serhuis/StopWater/assembly.FCStd

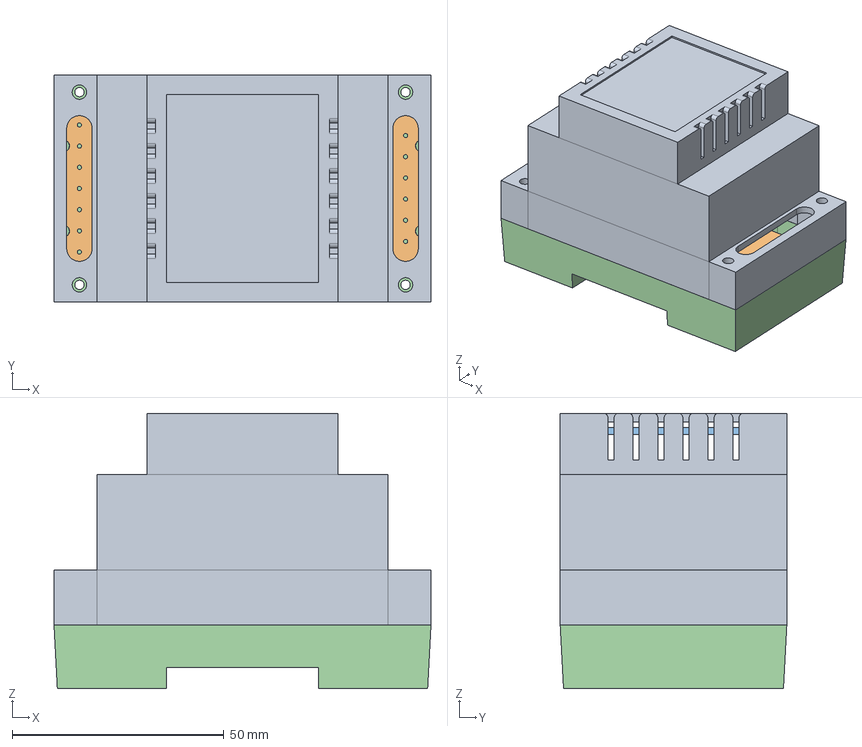
[picture p1: CAD file, 2023-11-07]
assembly.FCStd
89.0 x 53.5 x 65.0 mm
Kradex_z102_top_001
pcb1_001
pcb2_001
Kradex_z102_bottom_001
