serhuis/StopWater/Kradex_z102_top.FCStd

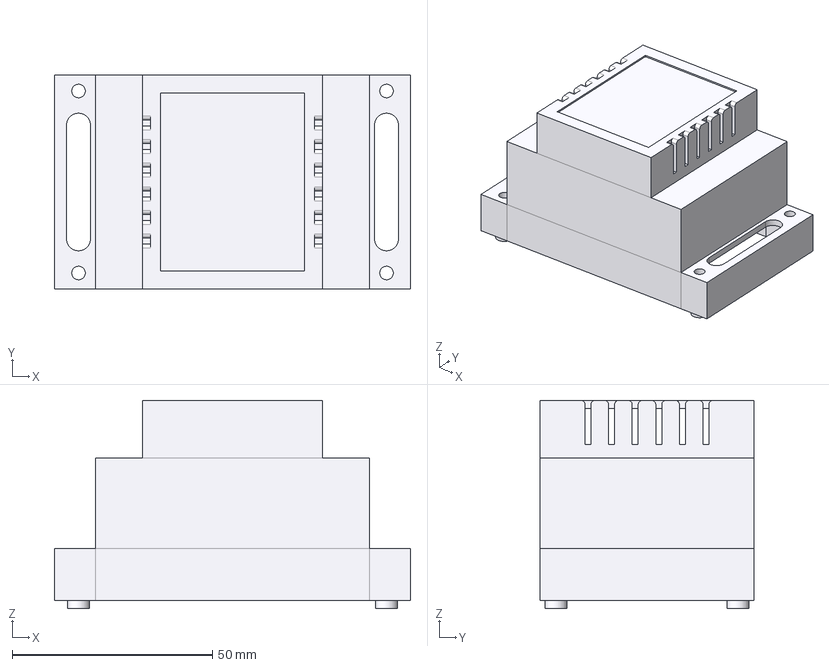
[picture p2: CAD file, 2023-11-07]
Kradex_z102_top.FCStd
89.0 x 53.5 x 52.0 mm
