serhuis/StopWater/Kradex_z102_bottom.FCStd

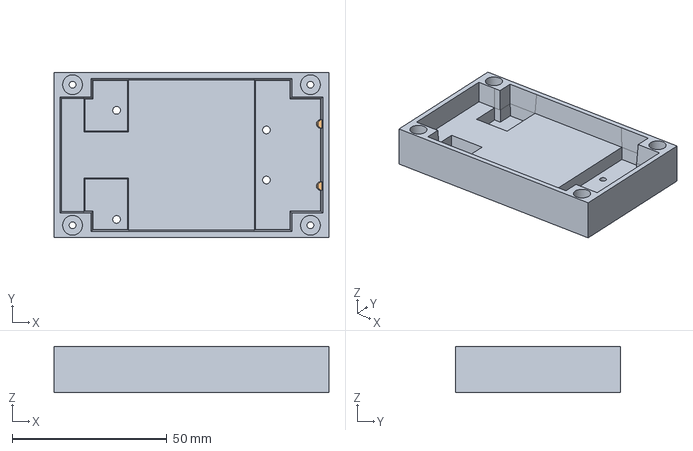
[picture p3: CAD file, 2023-11-07]
Kradex_z102_bottom.FCStd
89.0 x 53.5 x 15.0 mm
