serhuis/StopWater/DG301-5.0.FCStd

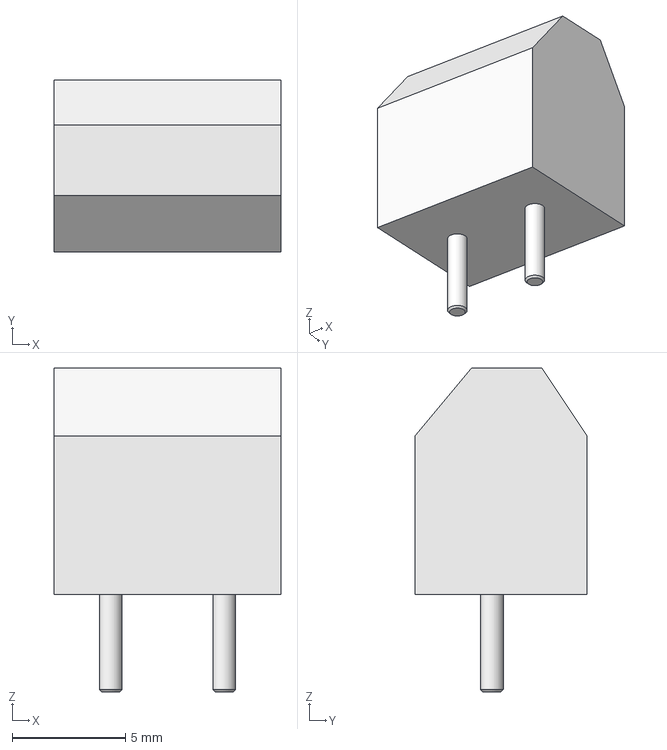
[picture p4: CAD file, 2023-11-07]
DG301-5.0.FCStd
10.0 x 7.60 x 14.3 mm
