serhuis/StopWater/pcb2.FCStd

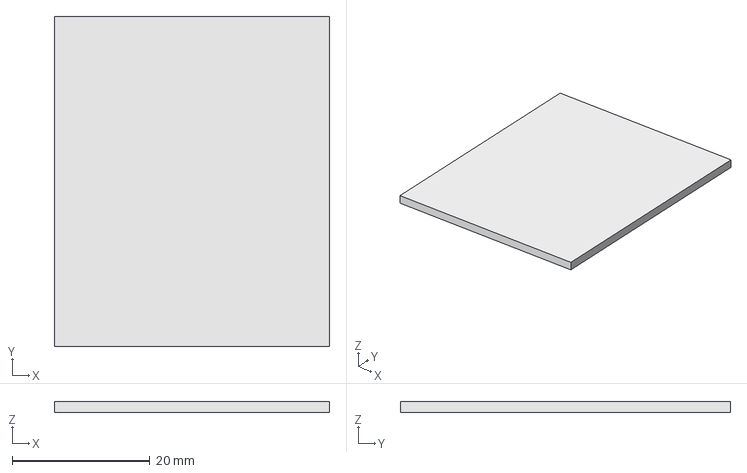
[picture p5: CAD file, 2023-11-07]
pcb2.FCStd
40.0 x 48.0 x 1.60 mm
