serhuis/StopWater/pcb2-BodyPad.dxf

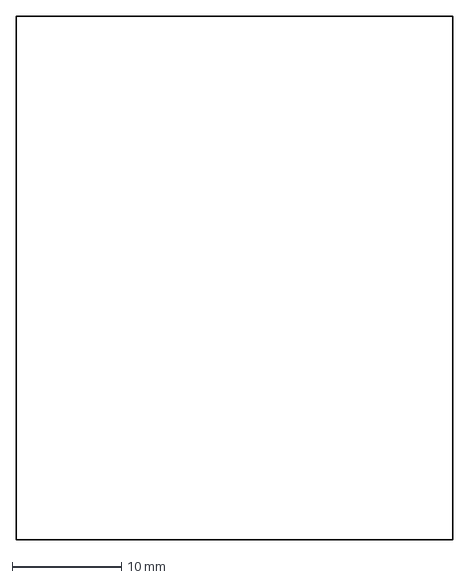
[picture p6: CAD file, 2023-11-07]
pcb2-BodyPad.dxf
40.0 x 48.0 mm
