serhuis/StopWater/pcb1.FCStd

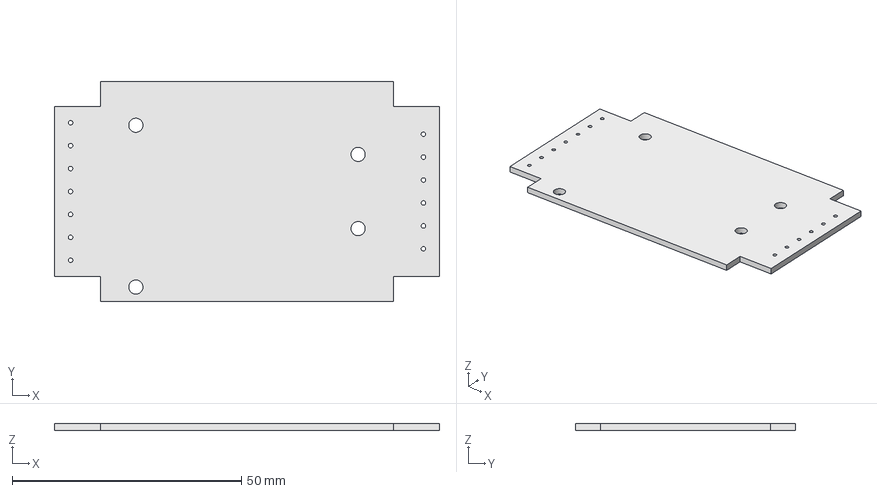
[picture p7: CAD file, 2023-11-07]
pcb1.FCStd
84.0 x 48.0 x 1.60 mm
