serhuis/StopWater/pcb1,1-Extrude.dxf

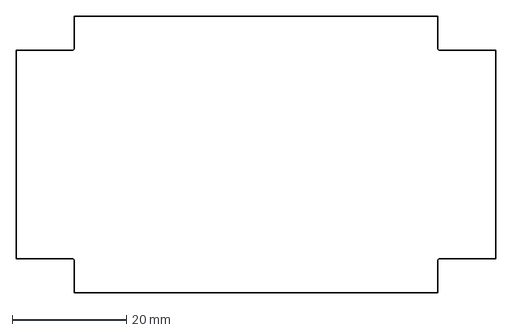
[picture p8: CAD file, 2023-06-02]
pcb1,1-Extrude.dxf
83.9 x 48.4 mm
