serhuis/StopWater/ex1-BodyPad001.stl

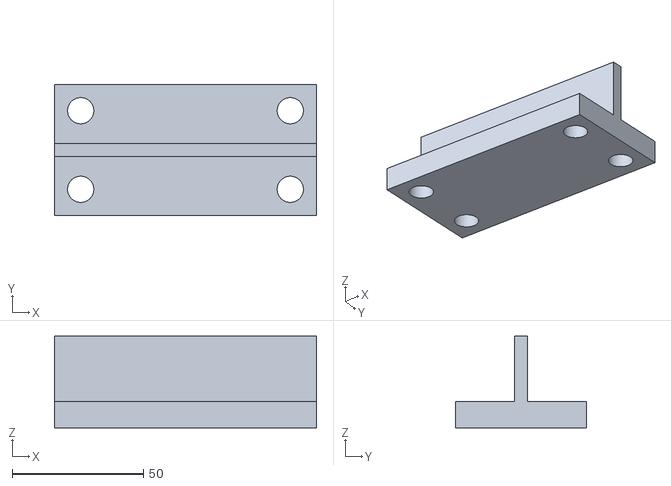
[picture p9: CAD file, 2023-06-02]
ex1-BodyPad001.stl
100.0 x 50.0 x 35.0
