serhuis/StopWater/ex1.FCStd

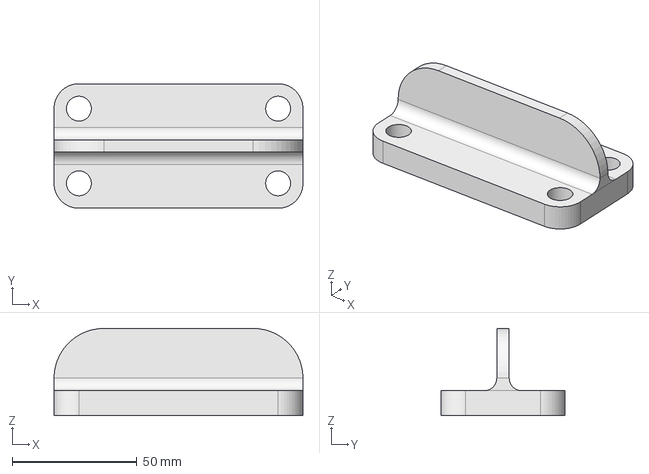
[picture p10: CAD file, 2023-06-02]
ex1.FCStd
100.0 x 50.0 x 35.0 mm
