serhuis/StopWater/pcb1-Extrude.dxf

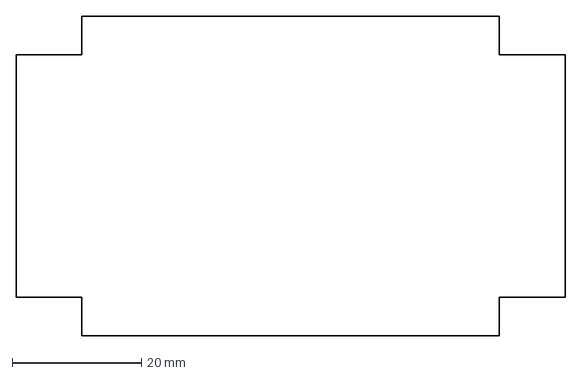
[picture p11: CAD file, 2023-06-02]
pcb1-Extrude.dxf
85.0 x 49.5 mm
