serhuis/StopWater/Gainta_d4mg.FCStd

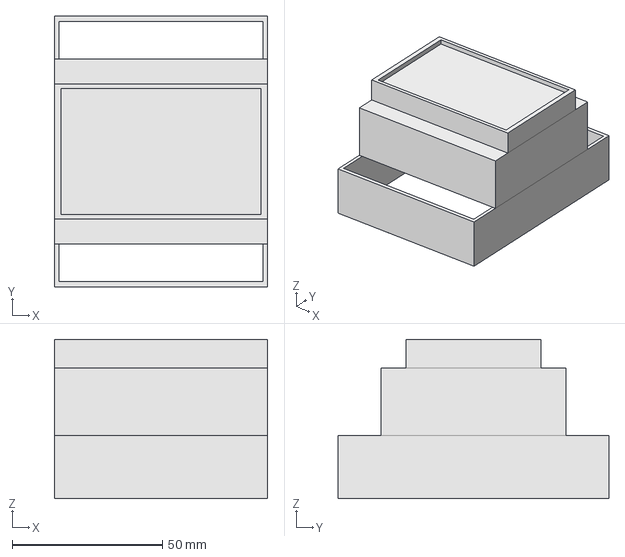
[picture p12: CAD file, 2023-06-02]
Gainta_d4mg.FCStd
71.0 x 90.2 x 53.0 mm
