serhuis/StopWater/(list of files, cad)

Other CAD files:
ex1-BodyFillet002.stl
