serhuis/StopWater/stopwater/stopwater.kicad_pcb

## KiCad design stopwater/stopwater.kicad_pcb (2023-11-07)

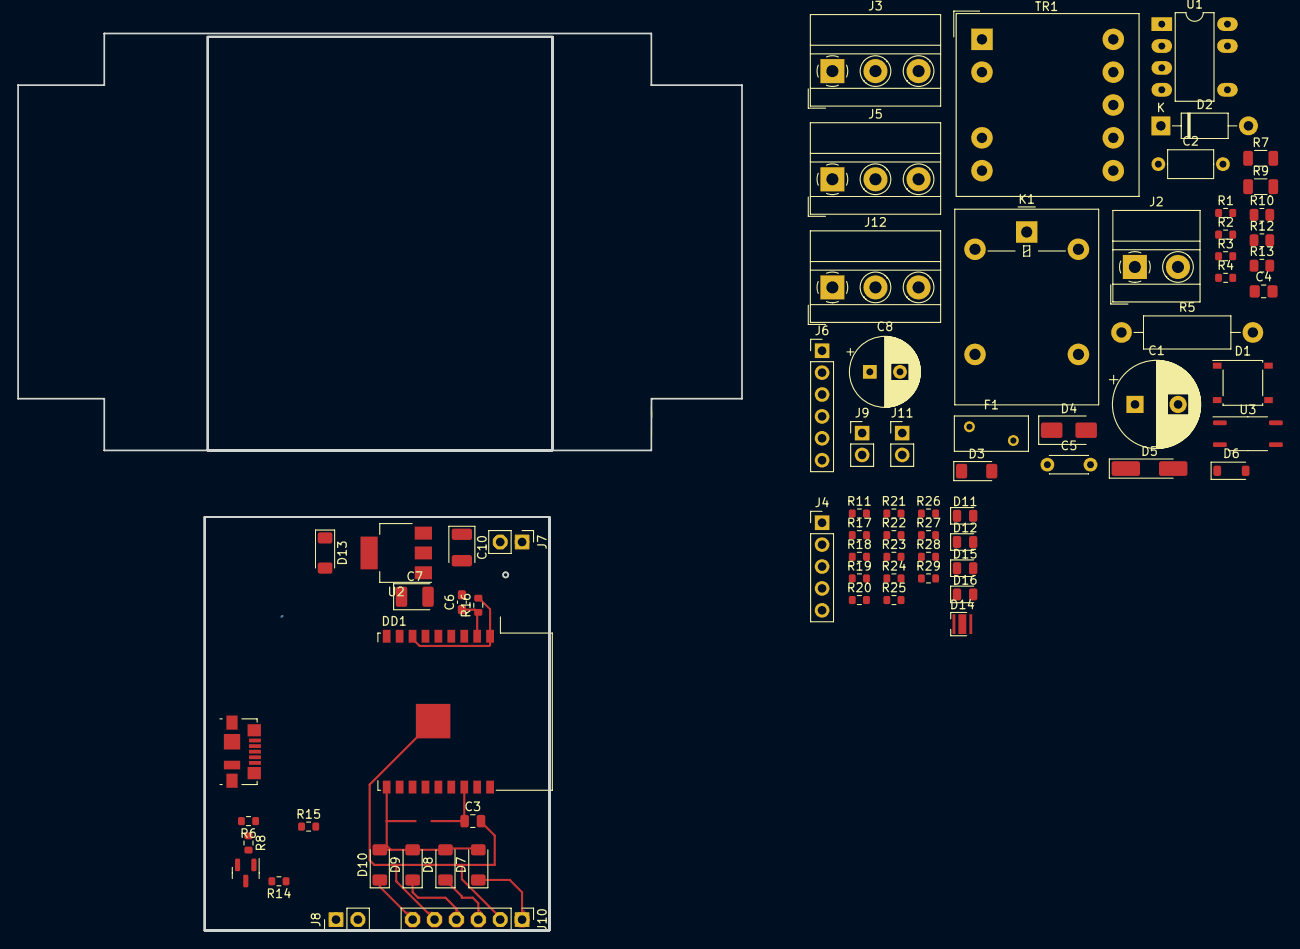
[picture p13: board stopwater.kicad_pcb from above]

Board: 2 copper layers, 84.0 x 104.1 mm, 74 parts (0 on the bottom side), 57 nets.

Parts:
C1: 10u 400v; CP_Radial_D10.0mm_P5.00mm
C2: 2.2n; C_Axial_L5.1mm_D3.1mm_P7.50mm_Horizontal
C3: 1u; C_0805_2012Metric
C4: C_Polarized_Small; C_0805_2012Metric_Pad1.18x1.45mm_HandSolder
C5: C_Polarized_Small; C_Disc_D4.3mm_W1.9mm_P5.00mm
C6: 0.1u; C_0603_1608Metric_Pad1.08x0.95mm_HandSolder
C7, C10: 10u; CP_EIA-3528-15_AVX-H
C8: 200u 16v; CP_Radial_D8.0mm_P3.50mm
D1: ABS10; Diode_Bridge_Diotec_ABS
D2: 1N4937; D_DO-41_SOD81_P10.16mm_Horizontal
D3, D7, D8, D9, D10, D13: LL4148; D_MiniMELF
D4: SS14; D_SMA
D5: 8v2; D_MiniMELF_Handsoldering
D6: MMSD4148; D_SOD-123
D11, D12: "SENS_1"; LED_0805_2012Metric
D14: LED_Dual_AAK; LED_Cree-XB
D15: "SENS_3"; LED_0805_2012Metric
D16: "SENS_4"; LED_0805_2012Metric
DD1: ESP32c3-WROOM-02; ESP-WROOM-02
F1: 8.2R; Fuse_BelFuse_0ZRE0005FF_L8.3mm_W3.8mm
J1: USB_B_Micro; USB_Micro-B_Molex_47346-0001
J2: ~220; TerminalBlock_MetzConnect_Type011_RT05502HBWC_1x02_P5.00mm_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
J3, J5, J12: Out; TerminalBlock_MetzConnect_Type011_RT05503HBWC_1x03_P5.00mm_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
J4: Conn_01x05; PinHeader_1x05_P2.54mm_Vertical
J6: Conn_01x06_Pin; PinHeader_1x06_P2.54mm_Vertical
J7, J9: Conn_01x02_Pin; PinHeader_1x02_P2.54mm_Vertical
J8, J11: Conn_01x02_Socket; PinHeader_1x02_P2.54mm_Vertical
J10: Conn_01x06_Socket; PinHeader_1x06_P2.54mm_Vertical
K1: G5LE-1; Relay_SPDT_Omron-G5LE-1
Q1: BC847; SOT-23
R1, R2, R3, R4, R14: 3.3k; R_0603_1608Metric
R5: 200k; R_Axial_DIN0411_L9.9mm_D3.6mm_P15.24mm_Horizontal
R6: 330; R_0603_1608Metric
R7, R9: 1M; R_1206_3216Metric
R8, R11, R16, R17, R18, R19, R20, R21, R22, R23, R24, R25, R26, R27, R28, R29: 10k; R_0603_1608Metric
R10: 10k; R_0805_2012Metric
R12: 330; R_0805_2012Metric
R13: 680; R_0805_2012Metric
R15: 1k; R_0603_1608Metric
TR1: FAT_74082
U1: TNY268P; PowerIntegrations_PDIP-8B
U2: LD1117S33TR_SOT223; SOT-223-3_TabPin2
U3: TLP181; SOIC-4_4.55x3.7mm_P2.54mm

Connections:
+3.3V: C3.1, C7.1, DD1.1 (3V3), R11.1, R16.2, R17.1, R18.1, R19.1, R20.1, R21.1, R22.1, R23.1, R24.1, R25.1, R26.1, R27.1, R28.1, R29.1, U2.2 (VO)
+12V: C8.1 (plus), D4.1 (K), D5.1 (K), D6.1 (K), D6.2 (A), J8.1, J9.1, J9.2, J11.1, K1.2, K1.5, R1.1, R2.1, R3.1, R4.1
/+12: C10.1, D13.1 (K), J7.1, U2.3 (VI)
/IO_0: D7.2 (A), DD1.18 (IO0), R17.2
/IO_1: D8.2 (A), DD1.17 (IO1), R18.2
/IO_2: DD1.16 (IO2), R19.2
/IO_3: D9.2 (A), DD1.15 (IO3), R20.2
/IO_4: DD1.3 (IO4), R6.2, R15.2, R21.2
/IO_5: D11.1 (K), DD1.4 (IO5), R22.2
/IO_6: D12.1 (K), DD1.5 (IO6), R23.2
/IO_7: D15.1 (K), DD1.6 (IO7), R24.2
/IO_8: D16.1 (K), DD1.7 (IO8), R25.2
/IO_9: DD1.8 (IO9), J4.2, R26.2
/IO_10: D10.2 (A), DD1.10 (IO10)
/SENSOR_1: D7.1 (K), J10.1
/SENSOR_2: D8.1 (K), J10.3
/SENSOR_3: D9.1 (K), J10.4
/SENSOR_4: D10.1 (K), J10.6
/USB_DN: DD1.13 (IO18), J1.2 (D-)
/USB_DP: DD1.14 (IO19), J1.3 (D+)
/power/SENSOR_1: J3.1, J6.1, R1.2
/power/SENSOR_2: J3.3, J6.3, R2.2, R3.2
/power/SENSOR_3: J5.1, J6.4
/power/SENSOR_4: J5.3, J6.6, R4.2
GND: C3.2, C6.2, C7.2, C10.2, D14.3 (K), DD1.9 (GND), DD1.19 (GND), J1.5 (GND), J1.6 (Shield), J3.2, J4.3, J5.2, J6.2, J6.5, J7.2, J10.2, J10.5, J11.2, Q1.2 (E), R8.1, R13.2, U2.1 (GND), U3.3
unnamed: C1.2 (minus), C4.2 (minus), D1.2 (-), TR1.1, U1.2 (S), U1.3 (S), U1.7 (S), U1.8 (S), U3.4
unnamed: C1.1 (plus), C2.2, C5.2 (minus), D1.1 (+), R5.2, R7.2, TR1.5
unnamed: C4.1 (plus), R10.2, U1.1 (BP)
unnamed: C5.1 (plus), C8.2 (minus), TR1.10
unnamed: D1.3, F1.2
unnamed: D2.2 (A), TR1.4, U1.5 (D)
unnamed: C2.1, D2.1 (K), R5.1
unnamed: D3.2 (A), TR1.2
unnamed: D3.1 (K), R10.1
unnamed: D4.2 (A), TR1.6
unnamed: D5.2 (A), R12.2
unnamed: D11.2 (A), R11.2
unnamed: D12.2 (A), R27.2
unnamed: D13.2 (A), J1.1 (VBUS)
unnamed: D14.1 (A1), R15.1
unnamed: D14.2 (A2), R14.1
unnamed: D15.2 (A), R28.2
unnamed: D16.2 (A), R29.2
unnamed: C6.1, DD1.2 (EN), J4.1, R16.1
unnamed: DD1.11 (RXD), J4.4
unnamed: DD1.12 (TXD), J4.5
unnamed: F1.1, J2.1
unnamed: D1.4, J2.2
unnamed: J8.2, Q1.3 (C), R14.2
unnamed: J12.1, K1.4
unnamed: J12.2, K1.1
unnamed: J12.3, K1.3
unnamed: Q1.1 (B), R6.1, R8.2
unnamed: R7.1, R9.2
unnamed: R12.1, R13.1, U3.1
unnamed: TR1.7, TR1.9
unnamed: R9.1, U1.4 (EN/UV), U3.6
