serhuis/StopWater/stopwater/PCB_zhaga_ready.kicad_pcb

## KiCad design stopwater/PCB_zhaga_ready.kicad_pcb (2023-11-07)

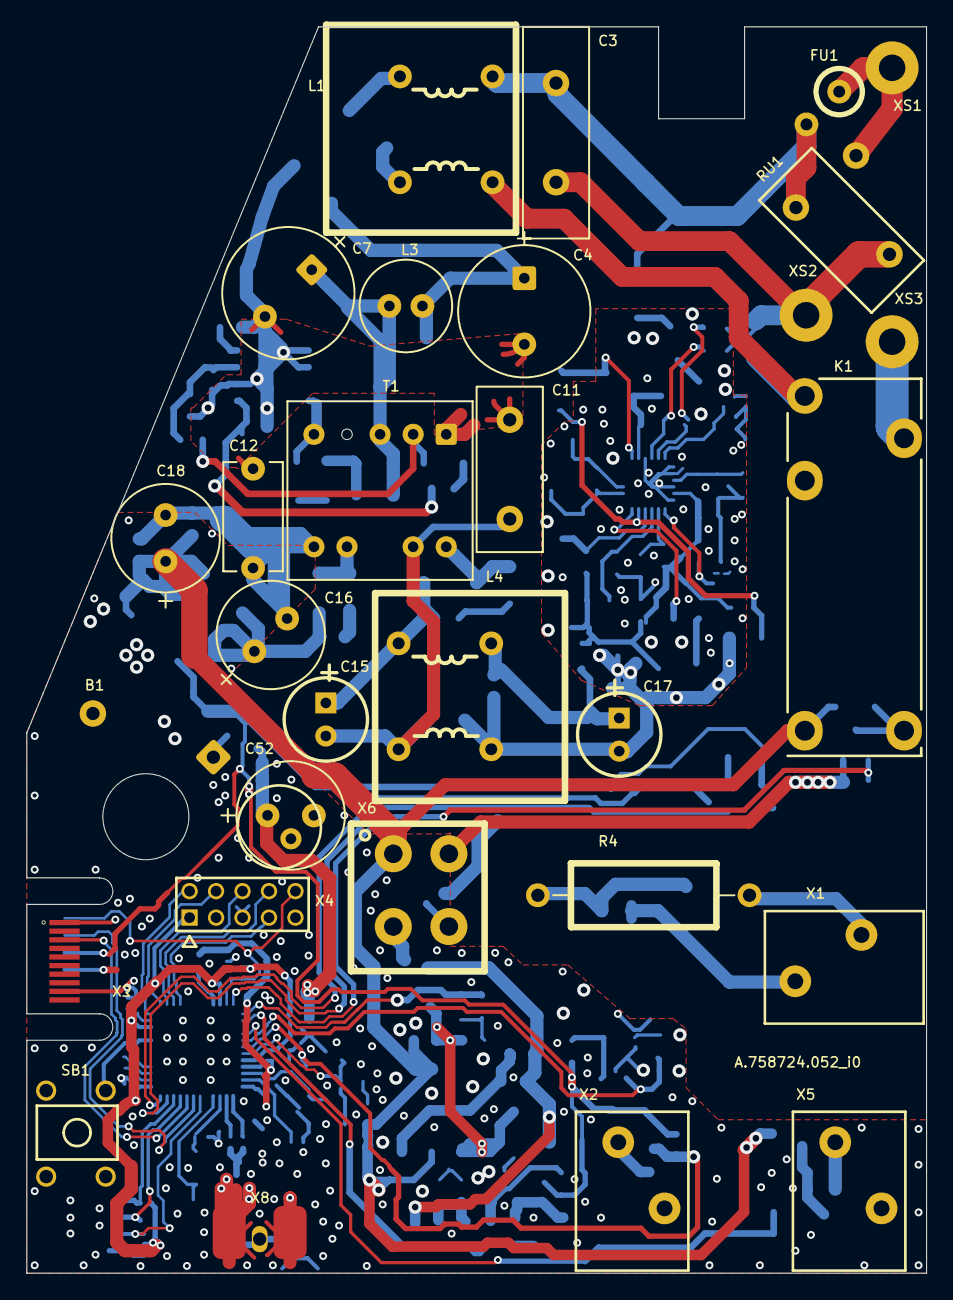
[picture p14: board PCB_zhaga_ready.kicad_pcb from above]

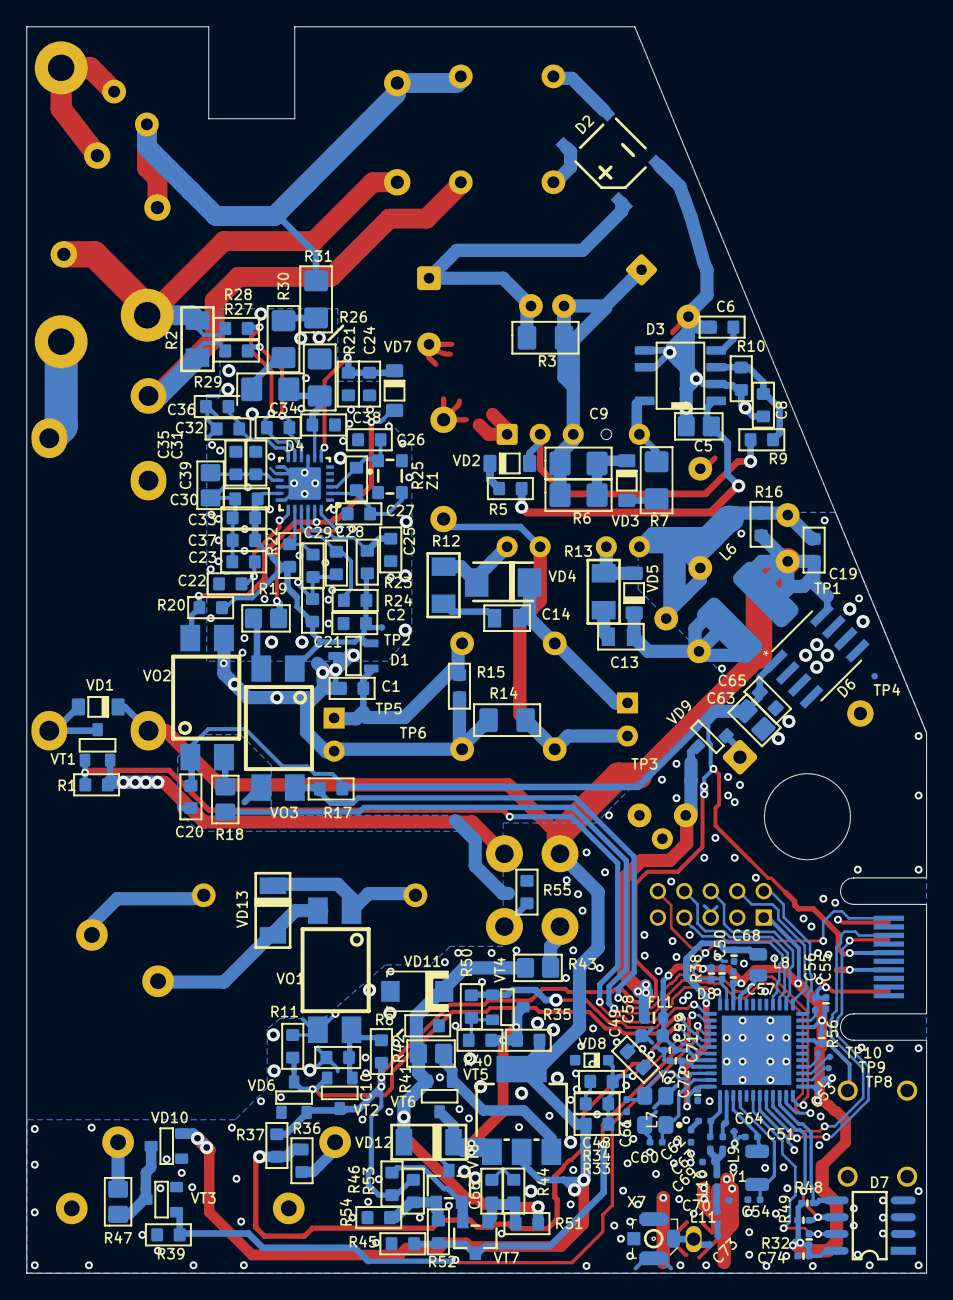
[picture p15: board PCB_zhaga_ready.kicad_pcb from below]

Board: 2 copper layers, 68.0 x 94.2 mm, 192 parts (162 on the bottom side), 105 nets.

Parts:
B1: BR-1225/VCN
C1, C6, C8, C34, C38, C49: 10nF 0603; 0603
C2: 22u 0603; 0603
C3: 1000pF 300VAC; L16W5 V
C4, C7: 4.7uF 400V; D10P5L12
C5: 10uF 35V; 0805
C9: 1000pF 300VAC; 1206
C10: 470nF 0603; 0603
C11: 1000pF 300VAC; L12.5W5
C12: 1000pF 300VAC; L7.5W5H6P7.5
C13, C14: SMD 0805-1000пФ±5% 50В X7R; __Altium_Library_Footprints_Passive.PcbLib_0805
C15, C17: 100uF 10V; D6.3P2.5L11.5
C16, C18: 470uF 10V; D8P3.5L12
C19, C20, C21, C23, C24, C25, C28, C29, C33, C35, C36, C48, C65, C66: SMD 0603-0.1мкФ±10% 25В X7R; 0603
C22, C37: SMD 0603-0,022мкФ±10% 25В X7R; 0603
C26, C27: SMD 0603 18pF±5% 50В; 0603
C30, C31, C32: 150pF 0603; 0603
C39: 2.2u 0805; 0805
C50, C53, C55, C57, C59, C68, C71, C72, C74: Cap; rlc_402_smd
C51, C54, C60, C61, C73: 12pF; CAPC1005X60B2N
C52: SuperCAP 022F; D8P3.5L12_2
C56: 1uF; CAPC1005X60B2N
C58: 10uF; CAPC1608X90N
C62: 6.8pF; CAPC1005X60B2N
C63: 22u 0603; 0805
C64, C67, C70: 1pF; CAPC1005X60B2N
C69: DNM_0402; CAPC1005X60B2N
D1: AP7384-33SA-7; SOT23_3
D2: Диодная сборка MDB10S; MDB10S
D3: MP020A-5GS; SO-7
D4: STPM32; QFN24L
D6: L78L33ABD-TR; SO-8_STM
D7: Микросхема CAT24C64WI-G; __Altium_Library_Footprints_SO.PcbLib_SO8
D8: CC2640R2LRGZ; QFNFC50P700X700X100-49A2N
FL1: BLM18HE152SN1; FIL_BLM18HE152SN1DL
FU1: Предохранитель самовосстанвливающийся RXE-185; FRN01W
K1: RM12-3011-35-1024; RM12
L1, L4: Дроссель B82732-W2601-B030; TLF9UAH103WR23K1
L3: CW57-332K; CW57
L6: CW57-332K; L0504
L7, L9: 2.4nH; INDC1005X60B2N
L8: 10uH; INDC2012X150L
L10, L11: 2nH; INDC1005X60B2N
R1, R11, R15, R16, R17, R20, R21, R22, R23, R24, R33, R34, R39, R50, R55: 0603 4.75K 1%; 0603
R2: SMD 1206-22 кОм±5%; __Altium_Library_Footprints_Passive.PcbLib_1206
R3, R14: 1206 4.75K; 1206
R4: 220K 2W; RSS2WH
R5: 0603 10 1%; 0603
R6, R7: 120K 0.5W; 1206
R8: 0603 200K 1%; 0603
R9, R10: 0603 43.2K 1%; 0603
R12, R13: SMD 1206-100 Ом±1%; __Altium_Library_Footprints_Passive.PcbLib_1206
R18, R19, R41, R43, R47: 0805 560 Ом 1%; 0805
R25: RC0603JR-071ML; 0603
R26: CMA02040X4700GB300; 1206
R27, R28: 0603 1K 1%; 0603
R29, R30, R31: SMM02040C2703FB300; 1206
R32, R38, R48, R49, R56: Resistor; rlc_402_smd
R35, R36, R37, R40, R42, R44, R45, R46, R51, R52, R53, R54: 0603 100K ±1%; 0603
RU1: V10E320P
SB1: Выключатель SWT-16; BUTTON
T1: TS7W-4.32-14.61-8.63; TS5W
TP1, TP2, TP3, TP4, TP5, TP6, TP8, TP9, TP10: Тестовая точка; TP0.5
VD1, VD3, VD5, VD7: ES1JFL; SOD123
VD2: BAV3004W; SOD123
VD4: Диод SS110; SMAE
VD6, VD10: BAT54S; SOT23_3
VD8: Супрессор GBLC03C; SOD323
VD9: BAT54C; SOT23_3
VD11: Супрессор SMAJ12A-TR; __Altium_Library_Footprints_DO.PcbLib_DO214AC
VD12, VD13: Диод LL4148; __Altium_Library_Footprints_SOD.PcbLib_SOD80
VO1, VO2, VO3: FOD817B3SD
VT1, VT3, VT4: DMN65D8L-7; SOT23_3
VT2, VT6: BC847C; SOT23_3
VT5: Транзистор BCP56-16T1; __Altium_Library_Footprints_SOT.PcbLib_SOT223
VT7, VT8: Транзистор BC857C; __Altium_Library_Footprints_SOT.PcbLib_SOT23
X1, X2, X5: KLEMM2; DG250-3.5-02P-11-00A
X3: X_20_2MM; TEST con
X4: X_10_2MM; X_10_2MM_Primary
X6: X_IDC_1_4; 10127820-0422LF
X7: 2337019-1; 0734120114
X8: 2337019-1; RG174
XS1, XS2, XS3: Отв.на плате; Pad 1mm2
Y1: 32.768kHz; XTAL_FC-135N
Y2: 24MHz; OSCCC250X320X60-4L
Z1: SJK-7U-16.00-16-30-80-A-30; SSCP32X25

Connections:
+3.3V: C20.1, C63.1, C65.1, D6.1, R8.2, R17.2, R37.2, R46.1, R53.1, TP3.1, VD6.2, VD9.2, VO2.1, VT2.3, X3.10
+3.3Vpm: C2.1, C21.2, C30.1, C33.2, C37.2, D1.2, D4.17, R20.1, R22.2, R23.2, R24.2, TP2.1, VO3.1
+5Vpm: C1.2, C17.1, D1.1, L4.4, R15.1, TP5.1
COM: FU1.1, XS1.1
DALI RX: D8.38, R45.1, R52.2, VT7.3
DALI TX: D8.37, R50.1, VT4.1
DCDC_SW: D8.33, L8.1
DIO4_SCL: D7.6, D8.9, R49.1
DIO5_SDA: D7.5, D8.10, R48.1
DIO8_MISO: D8.14, TP8.1
DIO9_MOSI: D8.15, TP9.1
DIO10_SCLK: D8.16, TP10.1
DIO14_BTN2: D8.20, R56.1, SB1.1
DIO16_TDO: D8.26, X4.6
DIO17_TDI: D8.27, X4.8
DIO18_RTS/SWO: D8.28, X4.7
DIO29_Analog: C49.2, D8.42, R36.2, R37.1
DIO30_Analog: C48.1, D8.43, R33.1, R34.2, VD8.2
GNDA: B1.2, C10.1, C12.1, C16.2, C18.2, C19.2, C20.2, C48.2, C49.1, C50.2, C51.2, C52.2, C53.2, C54.2, C55.2, C56.2, C57.2, C58.2, C59.2, C60.2, C61.2, C62.2, C63.2, C64.1, C65.2, C66.2, C68.2, C69.2, C70.1, C71.2, C72.2, C74.2, D6.2, D6.3, D6.6, D6.7, D7.2, D7.3, D7.4, D8.49, R1.2, R11.1, R16.2, R34.1, R39.2, R40.2, R42.2, R44.2, R45.2, R50.2, R54.2, R55.2, SB1.2, T1.6, TP4.1, VD6.1, VD8.1, VD10.1, VD11.1, VO1.3, VO3.3, VT1.2, VT3.2, VT4.2, VT8.3, X2.2, X3.1, X3.14, X3.17, X4.3, X4.5, X4.9, X5.2, X6.2, X7.1, X7.2, X7.3, X8.1, X8.2, Y2.2, Y2.4
GNDpm: C1.1, C2.2, C3.2, C17.2, C21.1, C22.2, C23.2, C24.1, C25.2, C26.2, C27.1, C28.2, C29.2, C30.2, C31.1, C32.2, C33.1, C35.2, C36.1, C37.1, C38.1, C39.1, D1.3, D4.9, D4.13, D4.14, D4.16, D4.18, D4.25, L4.3, R2.2, R14.2, R15.2, R21.2, R26.1, R28.1, RU1.1, TP6.1, VO2.3, XS2.1, Z1.2, Z1.4
JTAG_TCK: D8.25, X4.4
JTAG_TMS: D8.24, X4.2
MovRX: D8.7, X3.6
MovTX: D8.8, X3.5
NRST: C50.1, D8.35, R38.2, X3.2, X4.10
NetB1_1: B1.1, VD9.1
NetC3_1: C3.1, FU1.2, L1.2, R31.2, RU1.2
NetC4_1: C4.1, D2.1, L3.1, R3.1
NetC4_2: C4.2, C5.2, C6.1, C7.2, C8.1, C11.2, C12.2, D2.2, D3.2, D3.5, D3.6, R10.2, T1.1
NetC5_1: C5.1, D3.1, R5.2
NetC6_2: C6.2, D3.4
NetC7_1: C7.1, C9.1, L3.2, R3.2, R6.1, T1.3
NetC8_2: C8.2, D3.3, R9.2, R10.1
NetC9_2: C9.2, R6.2, VD3.2
NetC10_2: C10.2, R8.1, VO1.4, VT2.1
NetC11_1: C11.1, C15.2, L4.2, R14.1, T1.9
NetC13_1: C13.1, R13.2
NetC13_2: C13.2, C16.1, L6.1, VD5.2
NetC14_1: C14.1, R12.2
NetC14_2: C14.2, C15.1, L4.1, VD4.2
NetC22_1: C22.1, C23.1, D4.19
NetC24_2: C24.2, D4.7, R21.1, VD7.2
NetC25_1: C25.1, D4.22, R23.1
NetC26_1: C26.1, D4.3, R25.2, Z1.1
NetC27_2: C27.2, D4.2, R25.1, Z1.3
NetC28_1: C28.1, D4.21, R24.1
NetC29_1: C29.1, D4.20, R22.1
NetC31_2: C31.2, C35.1, C39.2, D4.15
NetC32_1: C32.1, C36.2, D4.12
NetC34_1: C34.1, D4.11, R28.2
NetC34_2: C34.2, D4.10, R27.2
NetC38_2: C38.2, D4.8, R26.2, R29.1
NetC51_1: C51.1, D8.3, Y1.1
NetC54_1: C54.1, D8.4, Y1.2
NetC56_1: C56.1, D8.23
NetC60_1: C60.1, D8.47, Y2.1
NetC61_1: C61.1, D8.46, Y2.3
NetC62_1: C62.1, L7.2
NetC64_2: C64.2, D8.2, L9.1
NetC66_1: C66.1, R44.1, R51.1, VT7.1
NetC67_1: C67.1, C69.1, L9.2, L10.1
NetC67_2: C67.2, D8.1, L7.1
NetC70_2: C70.2, L10.2, L11.1
NetC73_1: C73.1, L11.2
NetC73_2: C73.2, X7.4, X8.4
NetD2_3: D2.3, L1.3
NetD2_4: D2.4, L1.4
NetD3_7: D3.7, R7.2, T1.5
NetD4_23: D4.23, R20.2, VD7.1, VO2.4
NetD4_24: D4.24, R19.2
NetK1_1: K1.1, VD1.1, VT1.3
NetK1_4: K1.4, XS3.1
NetK1_5: K1.5, L1.1, R2.1, R27.1
NetR4_1: R4.1, X1.2
NetR4_2: R4.2, VD13.2, VO1.1
NetR5_1: R5.1, VD2.2
NetR7_1: R7.1, VD3.1
NetR9_1: R9.1, T1.2, VD2.1
NetR12_1: R12.1, T1.10, VD4.1
NetR13_1: R13.1, T1.7, VD5.1
NetR18_2: R18.2, VO2.2
NetR19_1: R19.1, VO3.2
NetR29_2: R29.2, R30.1
NetR30_2: R30.2, R31.1
NetR35_2: R35.2, R40.1, VD12.2, VT4.3, VT5.1, VT6.3
NetR36_1: R36.1, X2.1
NetR41_1: R41.1, VT5.3, VT6.1
NetR41_2: R41.2, R42.1, R43.1, R51.2, VD11.2, VD12.1, VT6.2
NetR46_2: R46.2, VT7.2, VT8.2
NetR47_1: R47.1, VD10.3, VT3.3
NetR52_1: R52.1, R53.2, R54.1, VT8.1
NetR55_1: R55.1, X6.4
NetVD13_1: VD13.1, VO1.2, X1.1
PHS: D8.41, R11.2, VD6.3, VT2.2
PM_RX: D8.12, R17.1, VO3.4
PM_TX: D8.11, R18.1
PO1: R47.2, X5.1
PO2: R43.2, X6.3
PWM: D8.40, R39.1, VT3.1
REL: D8.36, R1.1, VT1.1
VCC: C18.1, C19.1, D6.8, K1.2, L6.2, R16.1, R33.2, R35.1, TP1.1, VD1.2, VD10.2, VT5.2, VT5.4, X6.1
VDDR: C68.1, C71.1, C72.1, D8.45, D8.48, L8.2
VDDS: C53.1, C55.1, C57.1, C58.1, C59.1, C74.1, D7.8, D8.13, D8.22, D8.34, D8.44, FL1.1, R32.2, R38.1, R48.2, R49.2, R56.2, X4.1
WMCU_VDD: C52.1, FL1.2, VD9.3
WP: D7.7, D8.6, R32.1
